Pongkemon01/Zeabus-Elec-Hydrophone/Zeabus-Elec-Hydrophone-BOM.xlsx

Reference | Quantity | Value | Footprint | Element14 Code
C113 C116 C119 C122 | 4 | 18000pF | Capacitors_SMD:C_0603_HandSoldering | MC0603B183K
C1 C10 C11 C12 C13 C14 C15 C16 C17 C18 C19 C2 C20 C21 C22 C23 C24 C25 C26 C27 C3 C30 C31 C32 C33 C34 C35 C36 C37 C38 C39 C4 C40 C41 C42 C45 C46 C47 C48 C5 C53 C55 C6 C7 C8 C9 | 46 | 0.01uF | Capacitors_SMD:C_0603_HandSoldering | C0603C103M3
C147 | 1 | 100uF | Capacitors_SMD:C_0603_HandSoldering | GRM31CF50J107
C148 C149 C49 C50 C51 C52 C54 C56 | 8 | 1uF | Capacitors_SMD:C_0603_HandSoldering | MC0603X105K
C146 C28 C29 C43 C44 C61 | 6 | 10uF | Capacitors_SMD:C_0603_HandSoldering | GRM188R60J106
C100 C101 C106 C112 C114 C115 C117 C118 C120 C121 C123 C124 C125 C126 C127 C128 C129 C130 C131 C132 C133 C134 C135 C136 C137 C138 C139 C140 C141 C142 C143 C57 C58 C60 C64 C65 C70 C76 C77 C82 C88 C89 C94 | 43 | 0.1uF | Capacitors_SMD:C_0603_HandSoldering | MC0603B104J
C59 | 1 | 47uF | Capacitors_SMD:C_1206_HandSoldering | GRT31CR60J476
C62 | 1 | 390pF | Capacitors_SMD:C_0603_HandSoldering | C0603C391F5
C63 | 1 | 5600pF | Capacitors_SMD:C_0603_HandSoldering | 06031C562JA
C102 C105 C107 C110 C66 C69 C71 C74 C78 C81 C83 C86 C90 C93 C95 C98 | 16 | 22uF | Capacitors_SMD:C_0805_HandSoldering | JMK212BJ226
C103 C108 C67 C72 C79 C84 C91 C96 | 8 | 300pF | Capacitors_SMD:C_0603_HandSoldering | C0603C301J5
C104 C109 C144 C145 C68 C73 C80 C85 C92 C97 | 10 | 1000pF | Capacitors_SMD:C_0603_HandSoldering | MCMT18N102
C111 C75 C87 C99 | 4 | 100pF | Capacitors_SMD:C_0603_HandSoldering | MCMT18N101
CN1 CN2 CN3 CN4 | 4 | EPS.00.250.NTN | Zeabus:EPS-00-250 | EPS.00.250.NTN (DigiKey)
D1 D2 D6 | 3 | Yellow | LEDs:LED_0603 | MCL-S290YC
D3 D8 | 2 | Red | LEDs:LED_0603 | MCL-S290SRC
D4 D7 | 2 | Blue | LEDs:LED_0603 | MCL-S291SBLC
D5 D9 | 2 | Green | LEDs:LED_0603 | SML-LX0603GW
J1 | 1 | JTAG | Pin_Headers:Pin_Header_Straight_2x07_Pitch2.54mm | N2514-6002RB
J2 | 1 | USB_OTG | Connectors:USB_Mini-B | UX60SC-MB-5ST(80)
J10 J11 J12 J13 J14 J15 J16 J17 J18 J22 J3 J4 J5 J6 J7 J8 J9 | 17 | TEST_1P | SMD_Packages:1Pin | (Empty)
JP1 | 1 | Write Protect | Capacitors_SMD:C_0603_HandSoldering | (Empty)
JP2 | 1 | External Reset | Pin_Headers:Pin_Header_Straight_1x02_Pitch2.54mm | (Empty)
L1 L3 L5 L7 | 4 | 15mH | Zeabus:L-SDR0503 | SDR0503-153JL
L10 L11 L12 L13 L14 L15 L16 L17 L18 L19 L2 L20 L21 L4 L6 L8 L9 L22 | 18 | 120nH | Inductors_SMD:L_0603_HandSoldering | ELJRER12GFA
R1 R13 R14 R15 R16 R17 R18 R2 R21 R23 R25 R27 R28 R3 R36 R37 R7 R8 R96 R97 R98 R99 R100 | 23 | 10k | Resistors_SMD:R_0603_HandSoldering
R19 R29 R30 R31 R32 R33 R34 R35 | 8 | 330 | Resistors_SMD:R_0603_HandSoldering
R20 R22 R24 R26 R39 R44 R49 R54 R59 R64 R69 R74 R83 R84 R85 R86 R87 R88 R89 R90 | 20 | 100 | Resistors_SMD:R_0603_HandSoldering
R38 | 1 | 560 | Resistors_SMD:R_0603_HandSoldering
R4 R5 | 2 | 33 | Resistors_SMD:R_0603_HandSoldering
R40 R45 R50 R55 R60 R65 R70 R75 | 8 | 49.9k | Resistors_SMD:R_0603_HandSoldering
R41 R46 R51 R56 R61 R66 R71 R76 | 8 | 5.76k | Resistors_SMD:R_0603_HandSoldering
R42 R47 R52 R57 R62 R67 R72 R77 | 8 | 4.99k | Resistors_SMD:R_0603_HandSoldering
R43 R48 R53 R58 R63 R68 R73 R78 | 8 | 237 | Resistors_SMD:R_0603_HandSoldering
R6 | 1 | 47k | Resistors_SMD:R_0603_HandSoldering
R79 R80 R81 R82 | 4 | 274 | Resistors_SMD:R_0603_HandSoldering
R10 R11 R12 R9 | 4 | 22 | Resistors_SMD:R_0603_HandSoldering
R91 | 1 | 806 | Resistors_SMD:R_0603_HandSoldering
R92 | 1 | 1k | Resistors_SMD:R_0603_HandSoldering
R93 R94 R95 | 3 | 0 | Resistors_SMD:R_0603_HandSoldering | (Empty)
RN1 RN10 RN11 RN12 RN13 RN2 RN3 RN4 RN5 RN6 RN7 RN8 RN9 | 13 | EXBN8V-22 | Zeabus:CRA06S | CRA06S08322R0
SW1 | 1 | SW_DIP_x02 | Buttons_Switches_SMD:SW_DIP_x2_W5.08mm_Slide_Copal_CHS-A | MCDM(R)-02-T
SW2 SW3 SW4 SW5 SW6 | 5 | PB | Zeabus:Button-EVQ | EVQPT5A15
U1 | 1 | ADSP-21489BSWZ-4B | Zeabus:ADSP-21489-177 | ADSP-21489BSWZ-4B
U10 | 1 | FT232RQ | Housings_DFN_QFN:QFN-32-1EP_5x5mm_Pitch0.5mm | FT232RQ
U11 | 1 | AD1939WBSTZ | Housings_QFP:LQFP-64_10x10mm_Pitch0.5mm | AD1939WBSTZ
U13 | 1 | FOX924B - 12.288MHz | Zeabus:Oscillator-TCXO | FOX924B - 12.288MHz
U14 U15 U16 U17 | 4 | AD8652ARZ | Housings_SOIC:SOIC-8_3.9x4.9mm_Pitch1.27mm | AD8652ARZ
U18 | 1 | AD8334ACPZ | Zeabus:QFN50P900X900X100-65N | AD8334ACPZ
U19 | 1 | MAX5387LAUD+T | Housings_SSOP:TSSOP-14_4.4x5mm_Pitch0.65mm | MAX5387LAUD+T
U2 | 1 | FOX924B - 25MHz | Zeabus:Oscillator-TCXO | FOX924B - 25MHz
U20 | 1 | TLV73311PDBVT | TO_SOT_Packages_SMD:SOT-23-5_HandSoldering | TLV73311PDBVT
U21 U23 | 2 | LM1117-3.3 | TO_SOT_Packages_SMD:SOT-223-3Lead_TabPin2 | LM1117-3.3
U22 | 1 | TLV73311PDVBT | TO_SOT_Packages_SMD:SOT-23-5_HandSoldering | TLV73311PDVBT
U3 | 1 | S29GL032N | Housings_SSOP:TSOP-I-48_12x18.4mm_Pitch0.5mm | S29GL032N90TFI40
U12 U4 U5 | 3 | 74LVC1G08 | TO_SOT_Packages_SMD:SOT-353 | 74LVC1G08GW
U6 | 1 | ADM708SARZ | Zeabus:ADM708_R_8 | ADM708SARZ
U7 | 1 | 74LVC14 | Housings_SSOP:SSOP-14_5.3x6.2mm_Pitch0.65mm | 74LVC14APW
U8 | 1 | 74AC11244 | Housings_SSOP:TSSOP-24_4.4x7.8mm_Pitch0.65mm | 74AC11244APW
U9 | 1 | NCP361SNT1G | Zeabus:TSOP-5 | NCP361SNT1G
Y1 | 1 | CSTCC2M00G53-R0 | Crystals:Resonator_7.2x3mm | CSTCC2M00G53-R0
