Pongkemon01/Zeabus-Elec-Hydrophone/Zeabus-Elec-Hydrophone.kicad_pcb

## KiCad design Zeabus-Elec-Hydrophone.kicad_pcb (2017-11-07)

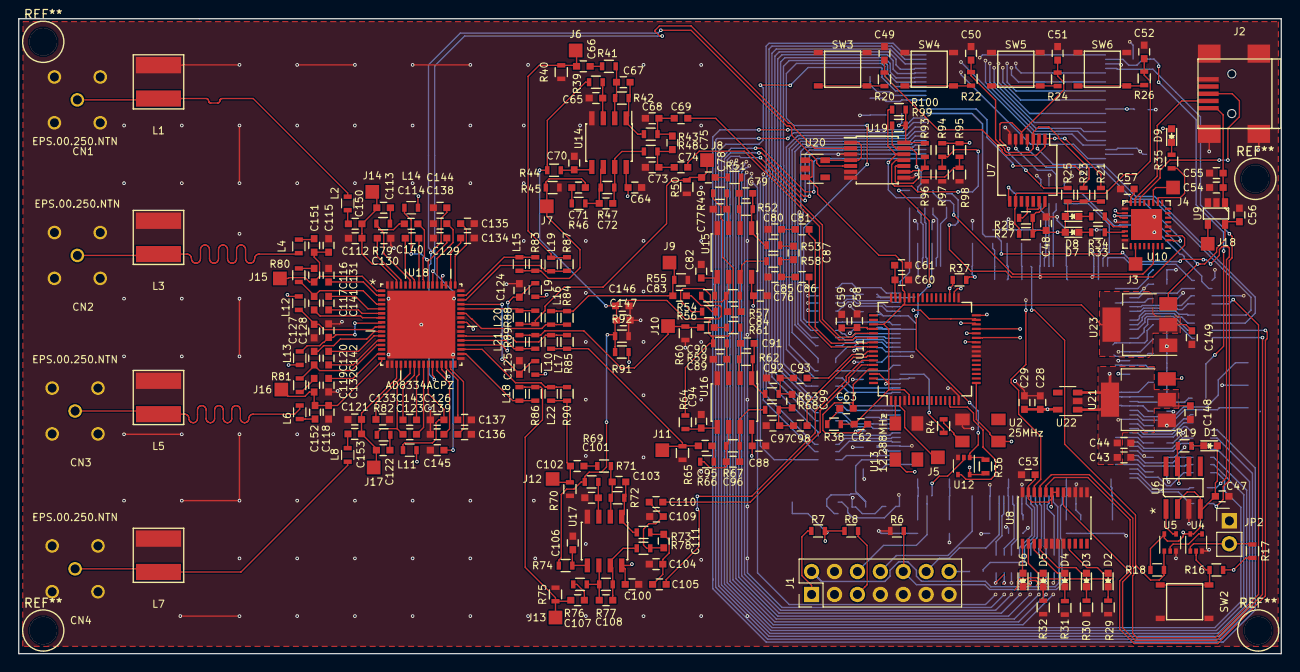
[picture p1: board Zeabus-Elec-Hydrophone.kicad_pcb from above]

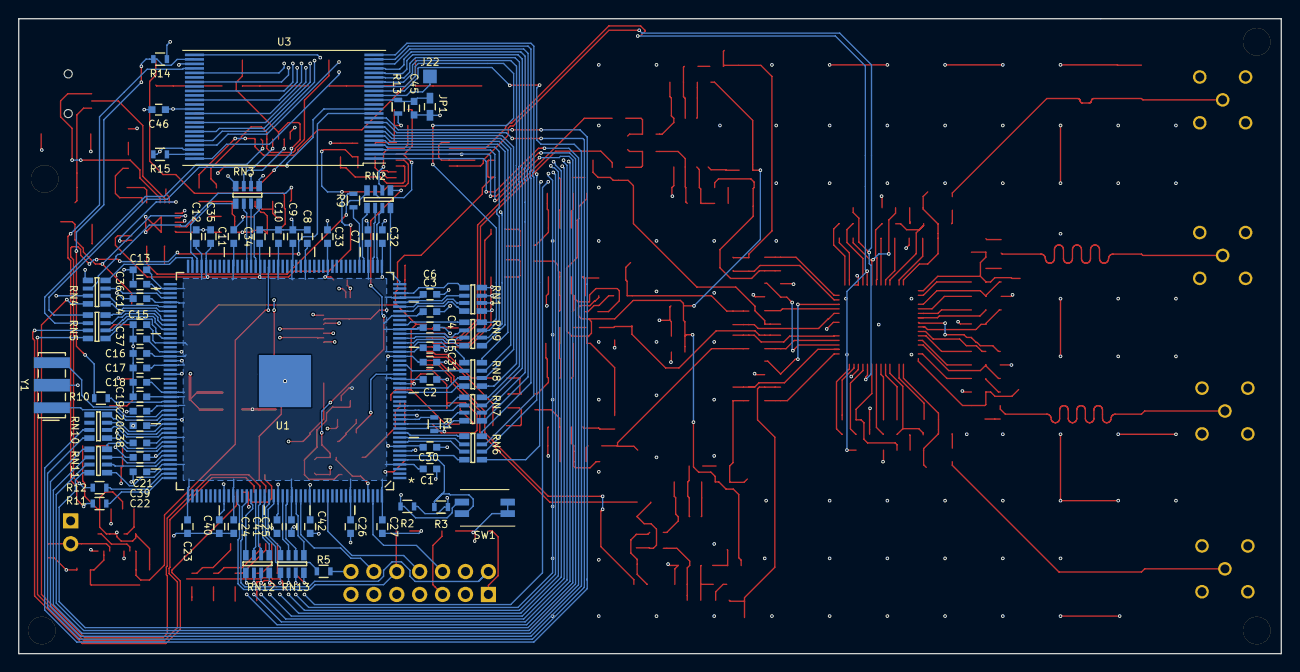
[picture p2: board Zeabus-Elec-Hydrophone.kicad_pcb from below]

Board: 4 copper layers, 140.0 x 70.4 mm, 352 parts (72 on the bottom side), 298 nets.

Parts:
C1, C2, C3, C4, C5, C6, C7, C8, C9, C10, C11, C12, C13, C14, C15, C16, C17, C18, C19, C20, C21, C22, C23, C24, C25, C26, C27, C30, C31, C32, C33, C34, C35, C36, C37, C38, C39, C40, C41, C42, C45, C46, C47, C48, C53, C55: 0.01uF; C_0603
C28, C29, C43, C44, C61, C146: 10uF; C_0603
C49, C50, C51, C52, C54, C56, C148, C149: 1uF; C_0603
C57, C58, C60, C64, C65, C70, C76, C77, C82, C88, C89, C94, C100, C101, C106, C114, C117, C120, C123, C124, C125, C126, C127, C128, C129, C130, C131, C132, C133, C134, C135, C136, C137, C138, C139, C140, C141, C142, C143, C150, C151, C152, C153: 0.1uF; C_0603
C59: 47uF; C_0603
C62: 390pF; C_0603
C63: 5600pF; C_0603
C66, C69, C71, C74, C78, C81, C83, C86, C90, C93, C95, C98, C102, C105, C107, C110: 22uF; C_0603
C67, C72, C79, C84, C91, C96, C103, C108: 300pF; C_0603
C68, C73, C80, C85, C92, C97, C104, C109, C144, C145: 1000pF; C_0603
C75, C87, C99, C111: 100pF; C_0603
C112, C115, C118, C121: 22pF; C_0603
C113, C116, C119, C122: 18000pF; C_0603
C147: 100uF; C_0603
CN1, CN2, CN3, CN4: EPS.00.250.NTN; EPS-00-250
D1, D2, D6: Yellow; LED_0603
D3, D8: Red; LED_0603
D4, D7: Blue; LED_0603
D5, D9: Green; LED_0603
J1: JTAG; Pin_Header_Straight_2x07_Pitch2.54mm
J2: USB_OTG; USB_Mini-B
J3, J4, J5, J6, J7, J8, J9, J10, J11, J12, J13, J14, J15, J16, J17, J18, J22: TEST_1P; 1Pin-TP
JP1: Write Protect; C_0603_HandSoldering
JP2: External Reset; Pin_Header_Straight_1x02_Pitch2.54mm
L1, L3, L5, L7: 15mH; L-SDR0503
L2, L4, L6, L8, L9, L10, L11, L12, L13, L14, L15, L16, L17, L18, L19, L20, L21, L22: 120nH; L_0603
R1, R2, R3, R7, R8, R13, R14, R15, R16, R17, R18, R21, R23, R25, R27, R28, R36, R37, R96, R97, R98, R99, R100: 10k; R_0603
R4, R5: 33; R_0603
R6: 47k; R_0603
R9, R10, R11, R12: 22; R_0603
R19, R29, R30, R31, R32, R33, R34, R35: 330; R_0603
R20, R22, R24, R26, R39, R44, R49, R54, R59, R64, R69, R74, R83, R84, R85, R86, R87, R88, R89, R90: 100; R_0603
R38: 560; R_0603
R40, R45, R50, R55, R60, R65, R70, R75: 49.9k; R_0603
R41, R46, R51, R56, R61, R66, R71, R76: 5.76k; R_0603
R42, R47, R52, R57, R62, R67, R72, R77: 4.99k; R_0603
R43, R48, R53, R58, R63, R68, R73, R78: 237; R_0603
R79, R80, R81, R82: 274; R_0603
R91: 806; R_0603
R92: 1k; R_0603
R93, R94, R95: 0; R_0603
RN1, RN2, RN3, RN4, RN5, RN6, RN7, RN8, RN9, RN10, RN11, RN12, RN13: EXBN8V-22; CRA06S
SW1: SW_DIP_x02; SW_DIP_x2_W5.08mm_Slide_Copal_CHS-A
SW2, SW3, SW4, SW5, SW6: PB; Button-EVQ
U1: ADSP-21489BSWZ-4B; ADSP-21489-177
U2: 25MHz; Oscillator-TCXO
U3: S29GL032N; TSOP-I-48_12x18.4mm_Pitch0.5mm
U4, U5, U12: 74LVC1G08; SOT-353
U6: ADM708SARZ; ADM708_R_8
U7: 74LVC14; SSOP-14_5.3x6.2mm_Pitch0.65mm
U8: 74AC11244; TSSOP-24_4.4x7.8mm_Pitch0.65mm
U9: NCP361SNT1G; TSOP-5
U10: FT232RQ; QFN-32-1EP_5x5mm_Pitch0.5mm
U11: AD1939WBSTZ; LQFP-64_10x10mm_Pitch0.5mm
U13: 12.288MHz; Oscillator-TCXO
U14, U15, U16, U17: AD8652ARZ; SOIC-8_3.9x4.9mm_Pitch1.27mm
U18: AD8334ACPZ; QFN50P900X900X100-65N
U19: MAX5387LAUD+T; TSSOP-14_4.4x5mm_Pitch0.65mm
U20: TLV73311PDBVT; SOT-23-5
U21, U23: LM1117-3.3; SOT-223-3Lead_TabPin2
U22: TLV73311PDVBT; SOT-23-5
Y1: CSTCC2M00G53-R0; Resonator_7.2x3mm

Connections:
+1V1: C1.1, C2.1, C3.1, C4.1, C5.1, C6.1, C7.1, C8.1, C9.1, C10.1, C11.1, C12.1, C13.1, C14.1, C15.1, C16.1, C17.1, C18.1, C19.1, C20.1, C21.1, C22.1, C23.1, C24.1, C25.1, C26.1, C27.1, C28.1, C29.1, U1.4, U1.23, U1.29, U1.34, U1.37, U1.41, U1.48, U1.62, U1.65, U1.68, U1.78, U1.85, U1.90, U1.93, U1.102, U1.105, U1.107, U1.113, U1.114, U1.116, U1.123, U1.129, U1.133, U1.143, U1.156, U1.169, U1.176, U22.5
+3.3VA: C62.1, C149.1, R38.2, U11.5, U11.45, U11.51, U11.62, U20.1, U20.3, U23.2
+3V3: C30.1, C31.1, C32.1, C33.1, C34.1, C35.1, C36.1, C37.1, C38.1, C39.1, C40.1, C41.1, C42.1, C43.1, C44.1, C46.1, C47.1, C48.1, C53.1, C148.1, D1.2, D7.2, D8.2, D9.2, R1.2, R7.2, R8.2, R13.1, R14.1, R16.1, R17.1, R18.1, R21.1, R23.1, R25.1, R27.1, R28.2, R36.1, R37.1, R93.1, R94.1, R95.1, R99.1, R100.1, SW1.1, SW1.2, U1.8, U1.28, U1.45, U1.57, U1.72, U1.84, U1.91, U1.104, U1.119, U1.126, U1.141, U1.153, U1.160, U2.VCC, U3.37, U4.5, U5.5, U6.2, U6.4, U7.14, U8.18, U8.19, U8.23, U11.17, U11.32, U12.5, U13.VCC, U19.14, U21.2, U22.1, U22.3
+5V: C56.1, C64.2, C76.2, C88.2, C100.2, L9.1, L10.1, L11.1, L12.1, L13.1, L14.1, R91.1, U9.5, U10.19, U14.8, U15.8, U16.8, U17.8, U18.29, U18.41, U18.51, U18.52, U21.3, U23.3
/ADC/ABCLK: RN3.1, U11.28
/ADC/ADC1LN: C74.2, U11.54
/ADC/ADC1LP: C69.2, U11.53
/ADC/ADC1RN: C86.2, U11.56
/ADC/ADC1RP: C81.2, U11.55
/ADC/ADC2LN: C98.2, U11.58
/ADC/ADC2LP: C93.2, U11.57
/ADC/ADC2RN: C110.2, U11.60
/ADC/ADC2RP: C105.2, U11.59
/ADC/ALRCLK: RN4.3, U11.29
/ADC/ASDATA1: RN4.1, U11.27
/ADC/ASDATA2: RN3.4, U11.26
/ADC/SPI_CLK: RN1.3, U11.34
/ADC/SPI_MISO: RN1.1, U11.31
/ADC/~AD1939_CS: R37.2, RN1.4, U11.35
/ADC/~AD1939_SOFT_RESET: R36.2, RN2.1, U12.1
/DSP-External_Port/DAI_P5_Z: RN4.8, U1.87
/DSP-External_Port/DAI_P6_Z: RN3.5, U1.86
/DSP-External_Port/DAI_P7_Z: RN3.8, U1.73
/DSP-External_Port/DAI_P8_Z: RN4.6, U1.94
/DSP-External_Port/DAI_P13_Z: RN3.7, U1.74
/DSP-External_Port/DAI_P14_Z: RN4.5, U1.95
/DSP-External_Port/DAI_P15_Z: RN5.5, U1.101
/DSP-External_Port/DAI_P16_Z: RN5.6, U1.99
/DSP-External_Port/DAI_P17_Z: RN5.7, U1.98
/DSP-External_Port/DAI_P18_Z: RN5.8, U1.97
/DSP-External_Port/DAI_P19_Z: RN3.6, U1.75
/DSP-External_Port/DAI_P20_Z: RN4.7, U1.92
/DSP-External_Port/DPI_P1_Z: RN1.8, U1.38
/DSP-External_Port/DPI_P2_Z: RN1.7, U1.39
/DSP-External_Port/DPI_P3_Z: RN1.6, U1.40
/DSP-External_Port/DPI_P5_Z: RN1.5, U1.42
/DSP-External_Port/DPI_P6_Z: RN2.8, U1.44
/DSP-External_Port/DPI_P7_Z: RN2.6, U1.47
/DSP-External_Port/DPI_P8_Z: RN2.7, U1.46
/DSP-External_Port/DPI_P9_Z: RN2.5, U1.49
/DSP-External_Port/DPI_P10_Z: R9.2, U1.50
/DSP-External_Port/LED1: RN3.2, U8.22
/DSP-External_Port/LED2: RN4.4, U8.21
/DSP-External_Port/LED3: RN5.4, U8.20
/DSP-External_Port/LED4: RN5.3, U8.17
/DSP-External_Port/PB1: RN5.2, U7.2
/DSP-External_Port/PB2: RN5.1, U7.4
/DSP-External_Port/PB3: RN3.3, U7.6
/DSP-External_Port/PB4: RN4.2, U7.8
/DSP-External_Port/SCL: R99.2, RN2.2, U19.13
/DSP-External_Port/SDA: R100.2, RN2.3, U19.12
/DSP-External_Port/SPI_MISO: RN1.2, U11.30
/DSP-External_Port/UART_RX: R9.1, U10.2
/DSP-External_Port/UART_TX: RN2.4, U10.30
/DSP-Memory/A0: RN6.1, U3.45
/DSP-Memory/A0_Z: RN6.8, U1.6
/DSP-Memory/A1: RN6.2, U3.25
/DSP-Memory/A1_Z: RN6.7, U1.9
/DSP-Memory/A2: RN6.3, U3.24
/DSP-Memory/A2_Z: RN6.6, U1.10
/DSP-Memory/A3: RN6.4, U3.23
/DSP-Memory/A3_Z: RN6.5, U1.11
/DSP-Memory/A4: RN7.1, U3.22
/DSP-Memory/A4_Z: RN7.8, U1.12
/DSP-Memory/A5: RN7.2, U3.21
/DSP-Memory/A5_Z: RN7.7, U1.13
/DSP-Memory/A6: RN7.3, U3.20
/DSP-Memory/A6_Z: RN7.6, U1.16
/DSP-Memory/A7: RN7.4, U3.19
/DSP-Memory/A7_Z: RN7.5, U1.17
/DSP-Memory/A8: RN8.1, U3.18
/DSP-Memory/A8_Z: RN8.8, U1.20
/DSP-Memory/A9: RN8.2, U3.8
/DSP-Memory/A9_Z: RN8.7, U1.21
/DSP-Memory/A10: RN8.3, U3.7
/DSP-Memory/A10_Z: RN8.6, U1.26
/DSP-Memory/A11: RN8.4, U3.6
/DSP-Memory/A11_Z: RN8.5, U1.30
/DSP-Memory/A12: RN9.1, U3.5
/DSP-Memory/A12_Z: RN9.8, U1.31
/DSP-Memory/A13: RN9.3, U3.4
/DSP-Memory/A13_Z: RN9.6, U1.33
/DSP-Memory/A14: RN11.4, U3.3
/DSP-Memory/A14_Z: RN11.5, U1.130
/DSP-Memory/A15: RN11.3, U3.2
/DSP-Memory/A15_Z: RN11.6, U1.128
/DSP-Memory/A16: RN11.2, U3.1
/DSP-Memory/A16_Z: RN11.7, U1.127
/DSP-Memory/A17: RN9.2, U3.48
/DSP-Memory/A17_Z: RN9.7, U1.32
/DSP-Memory/A18: RN9.4, U3.17
/DSP-Memory/A18_Z: RN9.5, U1.35
/DSP-Memory/A19: RN11.1, U3.16
/DSP-Memory/A19_Z: RN11.8, U1.125
/DSP-Memory/A20: RN10.4, U3.9
/DSP-Memory/A20_Z: RN10.5, U1.124
/DSP-Memory/A21: RN10.3, U3.10
/DSP-Memory/A21_Z: RN10.6, U1.122
/DSP-Memory/A22_Z: RN10.7, U1.121
/DSP-Memory/A23_Z: RN10.8, U1.120
/DSP-Memory/D0: RN12.1, U3.29
/DSP-Memory/D0_Z: RN12.8, U1.147
/DSP-Memory/D1: RN12.2, U3.31
/DSP-Memory/D1_Z: RN12.7, U1.148
/DSP-Memory/D2: RN12.3, U3.33
/DSP-Memory/D2_Z: RN12.6, U1.149
/DSP-Memory/D3: RN12.4, U3.35
/DSP-Memory/D3_Z: RN12.5, U1.150
/DSP-Memory/D4: RN13.1, U3.38
/DSP-Memory/D4_Z: RN13.8, U1.152
/DSP-Memory/D5: RN13.2, U3.40
/DSP-Memory/D5_Z: RN13.7, U1.154
/DSP-Memory/D6: RN13.3, U3.42
/DSP-Memory/D6_Z: RN13.6, U1.155
/DSP-Memory/D7: RN13.4, U3.44
/DSP-Memory/D7_Z: RN13.5, U1.157
/DSP-Memory/~AMI_RD: R11.1, U1.132
/DSP-Memory/~AMI_WR: R12.1, U1.131
/DSP-Memory/~Flash_CS: R10.2, R14.2, U3.26
/DSP-Memory/~MS1: R10.1, U1.115
/DSP-Memory/~RD: R11.2, U3.28
/DSP-Memory/~WR: R12.2, U3.11
/DSP_Misc/D+: J2.3, U10.14
/DSP_Misc/D-: J2.2, U10.15
/LNA/GAIN12: C145.1, U18.54, U19.2
/LNA/GAIN34: C144.1, U18.27, U19.5
/LNA/IN1: CN1.1, L1.1, L2.1
/LNA/IN2: CN2.1, L3.1, L4.1
/LNA/IN3: CN3.1, L5.1, L6.1
/LNA/IN4: CN4.1, L7.1, L8.1
/LNA/INH1: C112.1, C113.1, C150.2, J14.1, U18.62
/LNA/INH2: C115.1, C116.1, C151.2, J15.1, U18.1
/LNA/INH3: C118.1, C119.1, C152.2, J16.1, U18.16
/LNA/INH4: C121.1, C122.1, C153.2, J17.1, U18.19
/LNA/LNA1LN: C66.2, J6.1, L19.2, R40.2, R87.2
/LNA/LNA1LP: C71.2, J7.1, L15.2, R45.2, R83.2
/LNA/LNA1RN: C78.2, J8.1, L20.2, R50.2, R88.2
/LNA/LNA1RP: C83.2, J9.1, L16.2, R55.2, R84.2
/LNA/LNA2LN: C90.2, J10.1, L21.2, R60.2, R89.2
/LNA/LNA2LP: C95.2, J11.1, L17.2, R65.2, R85.2
/LNA/LNA2RN: C102.2, J12.1, L22.2, R70.2, R90.2
/LNA/LNA2RP: C107.2, J13.1, L18.2, R75.2, R86.2
/LNA/LON1: C114.1, R79.2, U18.59
/LNA/LON2: C117.1, R80.2, U18.4
/LNA/LON3: C120.1, R81.2, U18.13
/LNA/LON4: C123.1, R82.2, U18.22
/LNA/LOP1: C140.1, U18.58
/LNA/LOP2: C141.1, U18.5
/LNA/LOP3: C142.1, U18.12
/LNA/LOP4: C143.1, U18.23
/LNA/VIN1: C114.2, U18.56
/LNA/VIN2: C117.2, U18.7
/LNA/VIN3: C120.2, U18.10
/LNA/VIN4: C123.2, U18.25
/LNA/VIP1: C140.2, U18.57
/LNA/VIP2: C141.2, U18.6
/LNA/VIP3: C142.2, U18.11
/LNA/VIP4: C143.2, U18.24
GND: C1.2, C2.2, C3.2, C4.2, C5.2, C6.2, C7.2, C8.2, C9.2, C10.2, C11.2, C12.2, C13.2, C14.2, C15.2, C16.2, C17.2, C18.2, C19.2, C20.2, C21.2, C22.2, C23.2, C24.2, C25.2, C26.2, C27.2, C28.2, C29.2, C30.2, C31.2, C32.2, C33.2, C34.2, C35.2, C36.2, C37.2, C38.2, C39.2, C40.2, C41.2, C42.2, C43.2, C44.2, C45.2, C46.2, C47.2, C48.2, C49.2, C50.2, C51.2, C52.2, C53.2, C54.2, C55.2, C56.2, C57.1, C58.2, C59.2, C60.2, C61.2, C64.1, C65.2, C68.1, C70.2, C73.1, C76.1, C77.2, C80.1, C82.2, C85.1, C88.1, C89.2, C92.1, C94.2, C97.1, C100.1, C101.2, C104.1, C106.2, C109.1, C112.2, C115.2, C118.2, C121.2, C124.2, C125.2, C126.2, C127.2, C128.2, C129.2, C130.1, C131.1, C132.1, C133.1, C134.1, C135.1, C136.1, C137.1, C138.1, C139.1, C144.2, C145.2, C146.2, C147.2, C148.2, C149.2, CN1.2, CN1.3, CN1.4, CN1.5, CN2.2, CN2.3, CN2.4, CN2.5, CN3.2, CN3.3, CN3.4, CN3.5, CN4.2, CN4.3, CN4.4, CN4.5, J1.3, J1.4, J1.7, J1.9, J1.11, J1.13, J2.5, J2.6, JP1.2, JP2.1, L1.2, L3.2, L5.2, L7.2, R2.1, R3.1, R6.1, R15.2, R29.1, R30.1, R31.1, R32.1, R40.1, R45.1, R50.1, R55.1, R60.1, R65.1, R70.1, R75.1, R92.2, R96.2, R97.2, R98.2, SW2.1, SW2.3, SW3.1, SW3.3, SW4.1, SW4.3, SW5.1, SW5.3, SW6.1, SW6.3, U1.7, U1.15, U1.106, U1.109, U1.177, U2.GND, U3.27, U3.46, U4.3, U5.3, U6.3, U7.7, U8.5, U8.6, U8.7, U8.8, U8.13, U8.14, U8.15, U8.16, U8.24, U9.2, U9.3, U10.4, U10.17, U10.20, U10.24, U11.1, U11.4, U11.16, U11.23, U11.24, U11.25, U11.33, U11.44, U11.46, U11.48, U12.3, U13.GND, U14.4, U15.4, U16.4, U17.4, U18.17, U18.18, U18.33, U18.39, U18.42, U18.48, U18.63, U18.64, U18.65, U19.3, U19.6, U19.7, U19.8, U20.2, U21.1, U22.2, U23.1, Y1.2
unnamed: C45.1, JP1.1, R13.2, U3.14
unnamed: C49.1, R20.1, R21.2, U7.1
unnamed: C50.1, R22.1, R23.2, U7.3
unnamed: C51.1, R24.1, R25.2, U7.5
unnamed: C52.1, R26.1, R27.2, U7.9
unnamed: C54.1, C55.1, J2.1, U9.1
unnamed: C57.2, U10.1, U10.16
unnamed: C58.1, C59.1, U11.52
unnamed: C60.1, C61.1, U11.47
unnamed: C62.2, C63.2, U11.61
unnamed: C63.1, R38.1
unnamed: C65.1, R39.1, U14.3
unnamed: C66.1, R41.2
unnamed: C67.1, R42.1, R43.2, U14.1
unnamed: C67.2, R41.1, R42.2, U14.2
unnamed: C68.2, C69.1, C75.2, R43.1
unnamed: C70.1, R44.1, U14.5
unnamed: C71.1, R46.2
unnamed: C72.1, R47.1, R48.2, U14.7
unnamed: C72.2, R46.1, R47.2, U14.6
unnamed: C73.2, C74.1, C75.1, R48.1
unnamed: C77.1, R49.1, U15.3
unnamed: C78.1, R51.2
unnamed: C79.1, R52.1, R53.2, U15.1
unnamed: C79.2, R51.1, R52.2, U15.2
unnamed: C80.2, C81.1, C87.2, R53.1
unnamed: C82.1, R54.1, U15.5
unnamed: C83.1, R56.2
unnamed: C84.1, R57.1, R58.2, U15.7
unnamed: C84.2, R56.1, R57.2, U15.6
unnamed: C85.2, C86.1, C87.1, R58.1
unnamed: C89.1, R59.1, U16.3
unnamed: C90.1, R61.2
unnamed: C91.1, R62.1, R63.2, U16.1
unnamed: C91.2, R61.1, R62.2, U16.2
unnamed: C92.2, C93.1, C99.2, R63.1
unnamed: C94.1, R64.1, U16.5
unnamed: C95.1, R66.2
unnamed: C96.1, R67.1, R68.2, U16.7
unnamed: C96.2, R66.1, R67.2, U16.6
unnamed: C97.2, C98.1, C99.1, R68.1
unnamed: C101.1, R69.1, U17.3
unnamed: C102.1, R71.2
unnamed: C103.1, R72.1, R73.2, U17.1
unnamed: C103.2, R71.1, R72.2, U17.2
unnamed: C104.2, C105.1, C111.2, R73.1
unnamed: C106.1, R74.1, U17.5
unnamed: C107.1, R76.2
unnamed: C108.1, R77.1, R78.2, U17.7
unnamed: C108.2, R76.1, R77.2, U17.6
unnamed: C109.2, C110.1, C111.1, R78.1
unnamed: C113.2, R79.1
unnamed: C116.2, R80.1
unnamed: C119.2, R81.1
unnamed: C122.2, R82.1
unnamed: C124.1, L9.2, U18.36
unnamed: C125.1, L10.2, U18.45
unnamed: C126.1, L11.2, U18.26
unnamed: C127.1, L12.2, U18.9
unnamed: C128.1, L13.2, U18.8
unnamed: C129.1, L14.2, U18.55
unnamed: C130.2, U18.61
unnamed: C131.2, U18.2
unnamed: C132.2, U18.15
unnamed: C133.2, U18.20
unnamed: C134.2, U18.50
unnamed: C135.2, U18.49
unnamed: C136.2, U18.31
unnamed: C137.2, U18.30
unnamed: C138.2, U18.53
unnamed: C139.2, U18.28
unnamed: C150.1, L2.2
unnamed: C151.1, L4.2
unnamed: C152.1, L6.2
unnamed: C153.1, L8.2
unnamed: D1.1, R19.1
unnamed: D2.1, R29.2
unnamed: D2.2, U8.9
unnamed: D3.1, R30.2
unnamed: D3.2, U8.4
unnamed: D4.1, R31.2
unnamed: D4.2, U8.3
unnamed: D5.1, D6.1, R32.2
unnamed: D5.2, U8.2
unnamed: D6.2, U8.1
unnamed: D7.1, R33.2
unnamed: D8.1, R34.2
unnamed: D9.1, R35.2
unnamed: J1.1, R7.1
unnamed: J1.2, U1.146
unnamed: J1.5, R8.1
unnamed: J1.6, U1.174
unnamed: J1.8, U1.164
unnamed: J1.10, R6.2, U1.144
unnamed: J1.12, U1.158
unnamed: J1.14, R5.2
unnamed: J3.1, U10.26
unnamed: J4.1, U10.11
unnamed: J5.1, U11.3
unnamed: J18.1, U9.4
unnamed: J22.1, U3.15
unnamed: JP2.2, R17.2, U4.1
unnamed: L15.1, R83.1, U18.47
unnamed: L16.1, R84.1, U18.43
unnamed: L17.1, R85.1, U18.38
unnamed: L18.1, R86.1, U18.34
unnamed: L19.1, R87.1, U18.46
unnamed: L20.1, R88.1, U18.44
unnamed: L21.1, R89.1, U18.37
unnamed: L22.1, R90.1, U18.35
unnamed: R1.1, U1.14
unnamed: R2.2, SW1.3, U1.22
unnamed: R3.2, SW1.4, U1.5
unnamed: R4.1, U2.OUT
unnamed: R4.2, U1.24
unnamed: R5.1, U1.151
unnamed: R15.1, U3.47
unnamed: R16.2, SW2.2, SW2.4, U4.2
unnamed: R18.2, U1.70, U5.1
unnamed: R20.2, SW3.2, SW3.4
unnamed: R22.2, SW4.2, SW4.4
unnamed: R24.2, SW5.2, SW5.4
unnamed: R26.2, SW6.2, SW6.4
unnamed: R28.1, U7.11, U7.13
unnamed: R33.1, U10.22
unnamed: R34.1, U10.21
unnamed: R35.1, U10.10
unnamed: R93.2, R96.1, U19.9
unnamed: R94.2, R97.1, U19.11
unnamed: R95.2, R98.1, U19.10
unnamed: U1.117, Y1.3
unnamed: U1.118, Y1.1
unnamed: U4.4, U5.2
unnamed: U5.4, U6.1
unnamed: U11.2, U13.OUT
unnamed: U11.14, U12.4
unnamed: U19.1, U19.4, U20.5
VA_REF: C146.1, C147.1, R39.2, R44.2, R49.2, R54.2, R59.2, R64.2, R69.2, R74.2, R91.2, R92.1
~RESET: R19.2, U1.173, U3.12, U6.7, U10.18, U12.2
