Pongkemon01/Zeabus-Elec-Hydrophone/(commit log)

2017-08-22 First release of the schematic.
    [ADC.sch, Analog.sch, DSP-External_Port.sch, DSP-Memory.sch, DSP.sch, DSP_Misc.sch, LNA.sch, LNA_Gain_Ctrl.sch]
2017-08-23 First schematic release
    [ADC.sch, DSP-External_Port.sch, DSP-Memory.sch, DSP_Misc.sch, LNA.sch, LNA_Gain_Ctrl.sch, Power_Amp.sch, Zeabus-Elec-Hydrophone-BOM.xlsx]
2017-09-01 - Add C150 - C153 at LNA input - Change value of C112, C115, C118, C221 at LNA input - Finished PCB lay-out. Ready to route
    [ADC.sch, DSP-External_Port.sch, DSP-Memory.sch, DSP_Misc.sch, LNA.sch, LNA_Gain_Ctrl.sch, Power_Amp.sch, Zeabus-Elec-Hydrophone.kicad_pcb]
2017-09-12 Finished PCB routing. Ready for manufacture
    [Zeabus-Elec-Hydrophone.kicad_pcb]
2017-09-17 Add stitched vias around analog components
    [Zeabus-Elec-Hydrophone.kicad_pcb]
2017-10-20 Correction for silkscreen and add board-holding knot-hole
    [Zeabus-Elec-Hydrophone.kicad_pcb]
2017-11-07 Bug fixed of misplaced via
    [Zeabus-Elec-Hydrophone.kicad_pcb]
2017-11-29 Update to conform KiCad4.0.7
    [ADC.sch, DSP-External_Port.sch, DSP-Memory.sch, DSP_Misc.sch, LNA.sch, LNA_Gain_Ctrl.sch, Power_Amp.sch, Zeabus-Elec-Hydrophone.sch]
